vrubel/indicator-fun-V3s/README.md

# indicator-fun-V3s
Device "indicator.fun" implementation on the processor Allwinner V3s

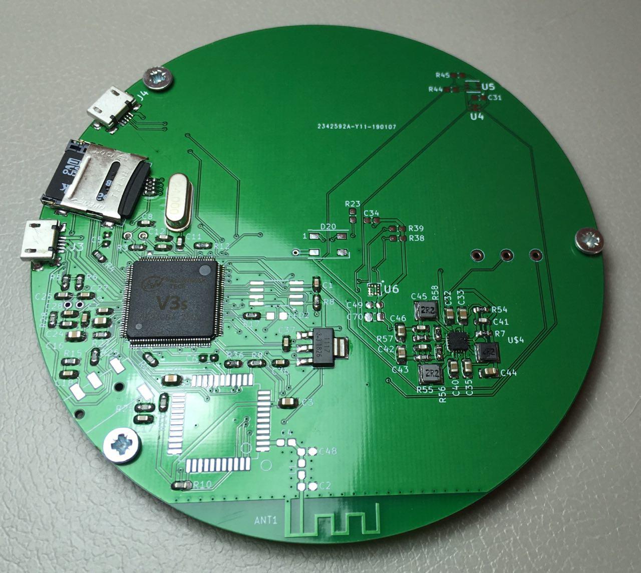
[picture p1: images/V1.0-bottom.jpg]
V1.0-bottom
  
   
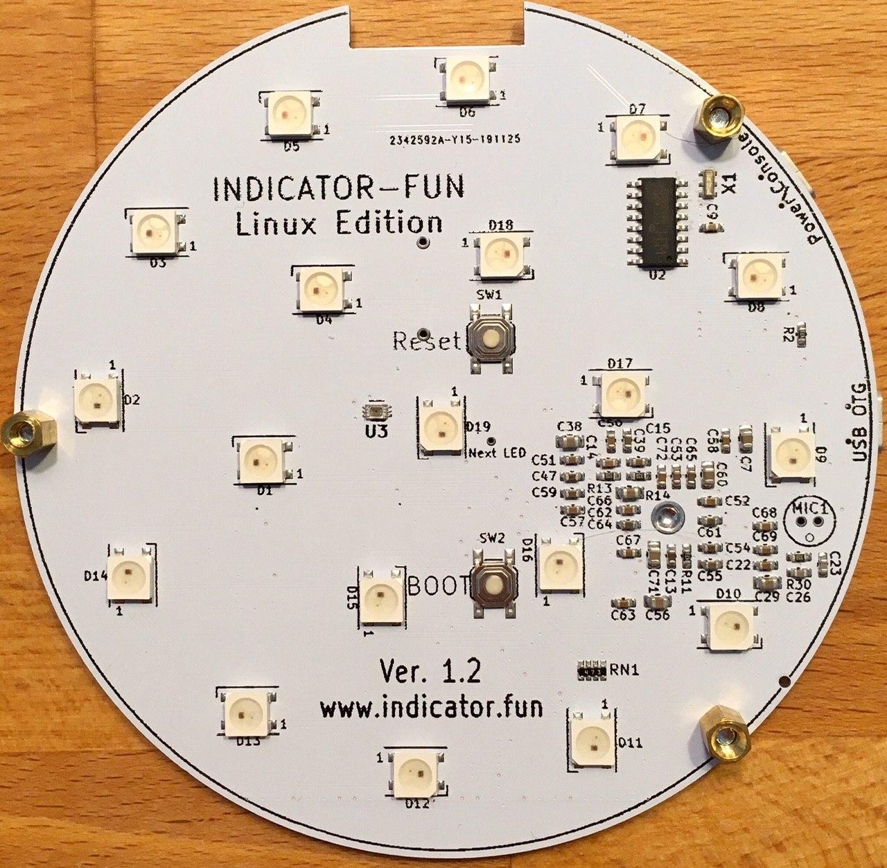
[picture p2: images/bottom-v-1.2.jpg]
V1.1-white-bottom
  
   
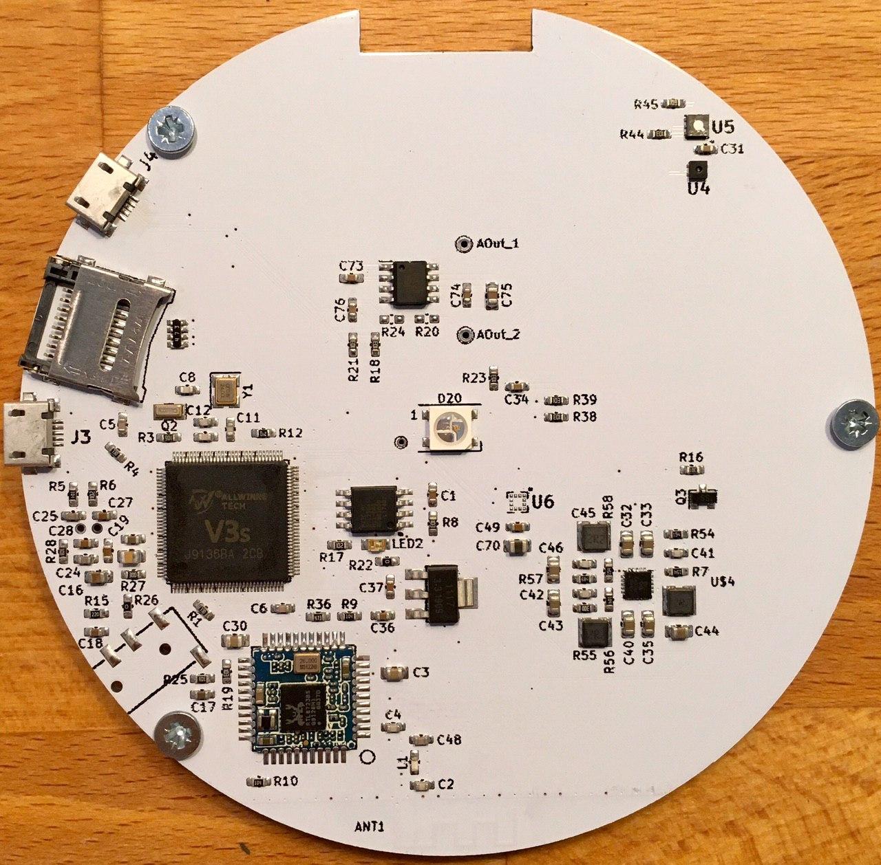
[picture p3: images/top-v-1.2.jpg]
V1.1-white-top
