vrubel/indicator-fun-V3s/Hardware/indicator-fun-v3s.kicad_pcb

## KiCad design Hardware/indicator-fun-v3s.kicad_pcb (2019-11-24)

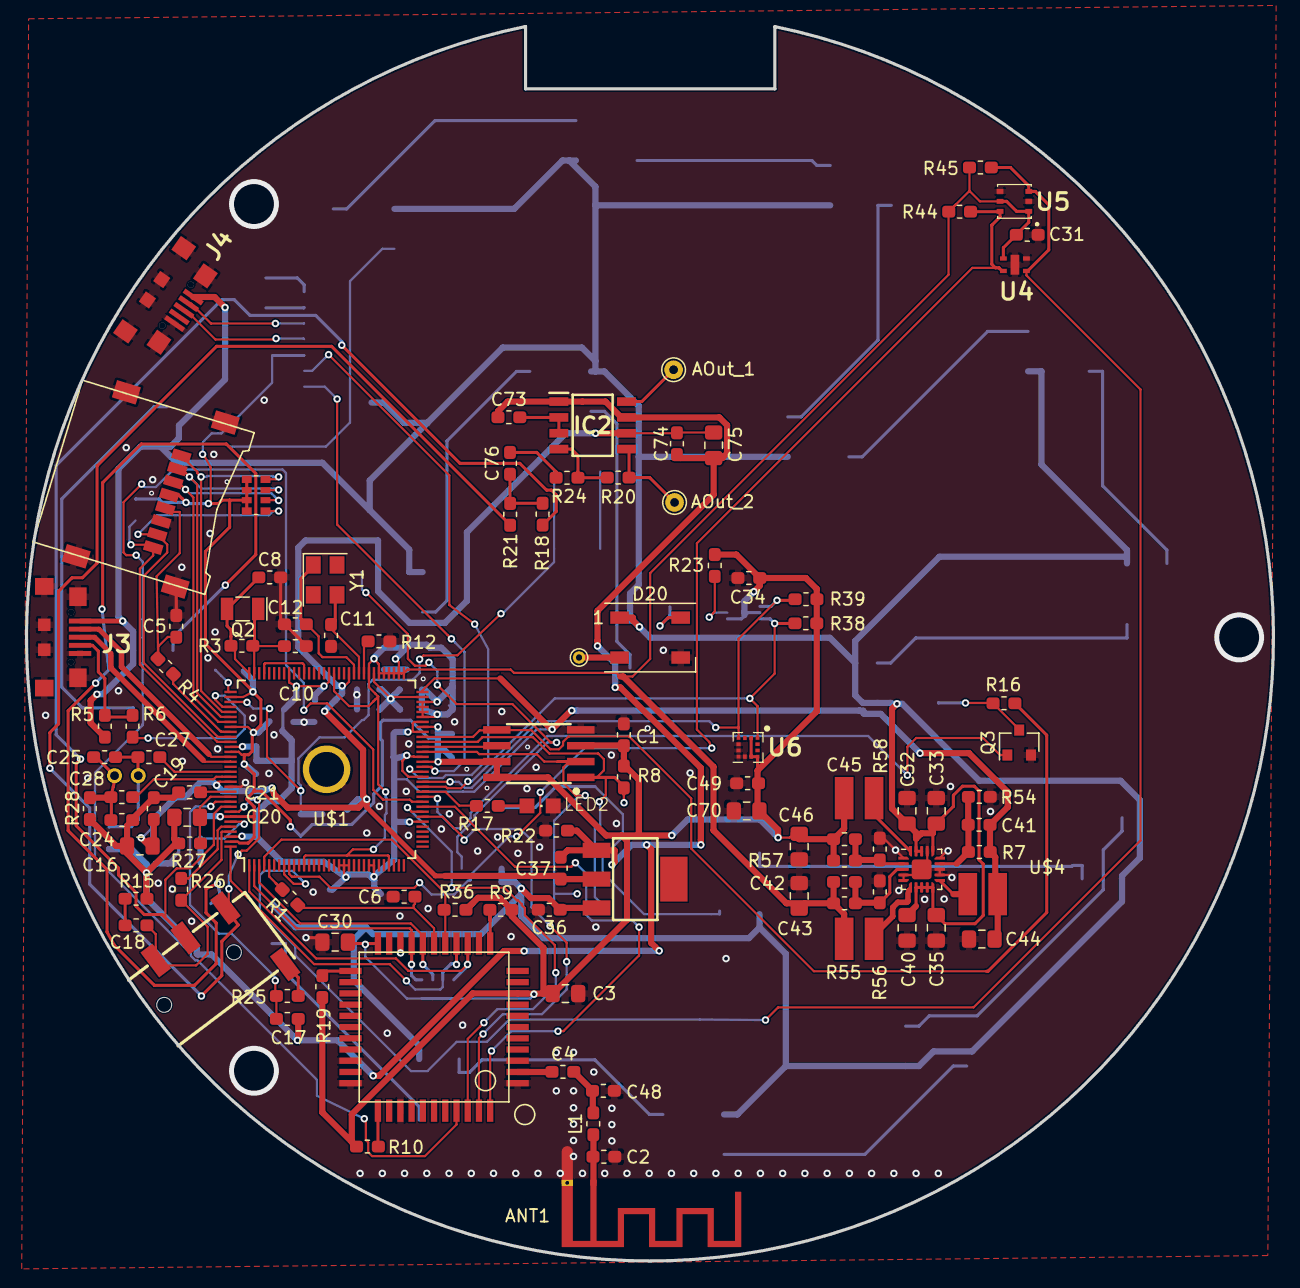
[picture p4: board indicator-fun-v3s.kicad_pcb from above]

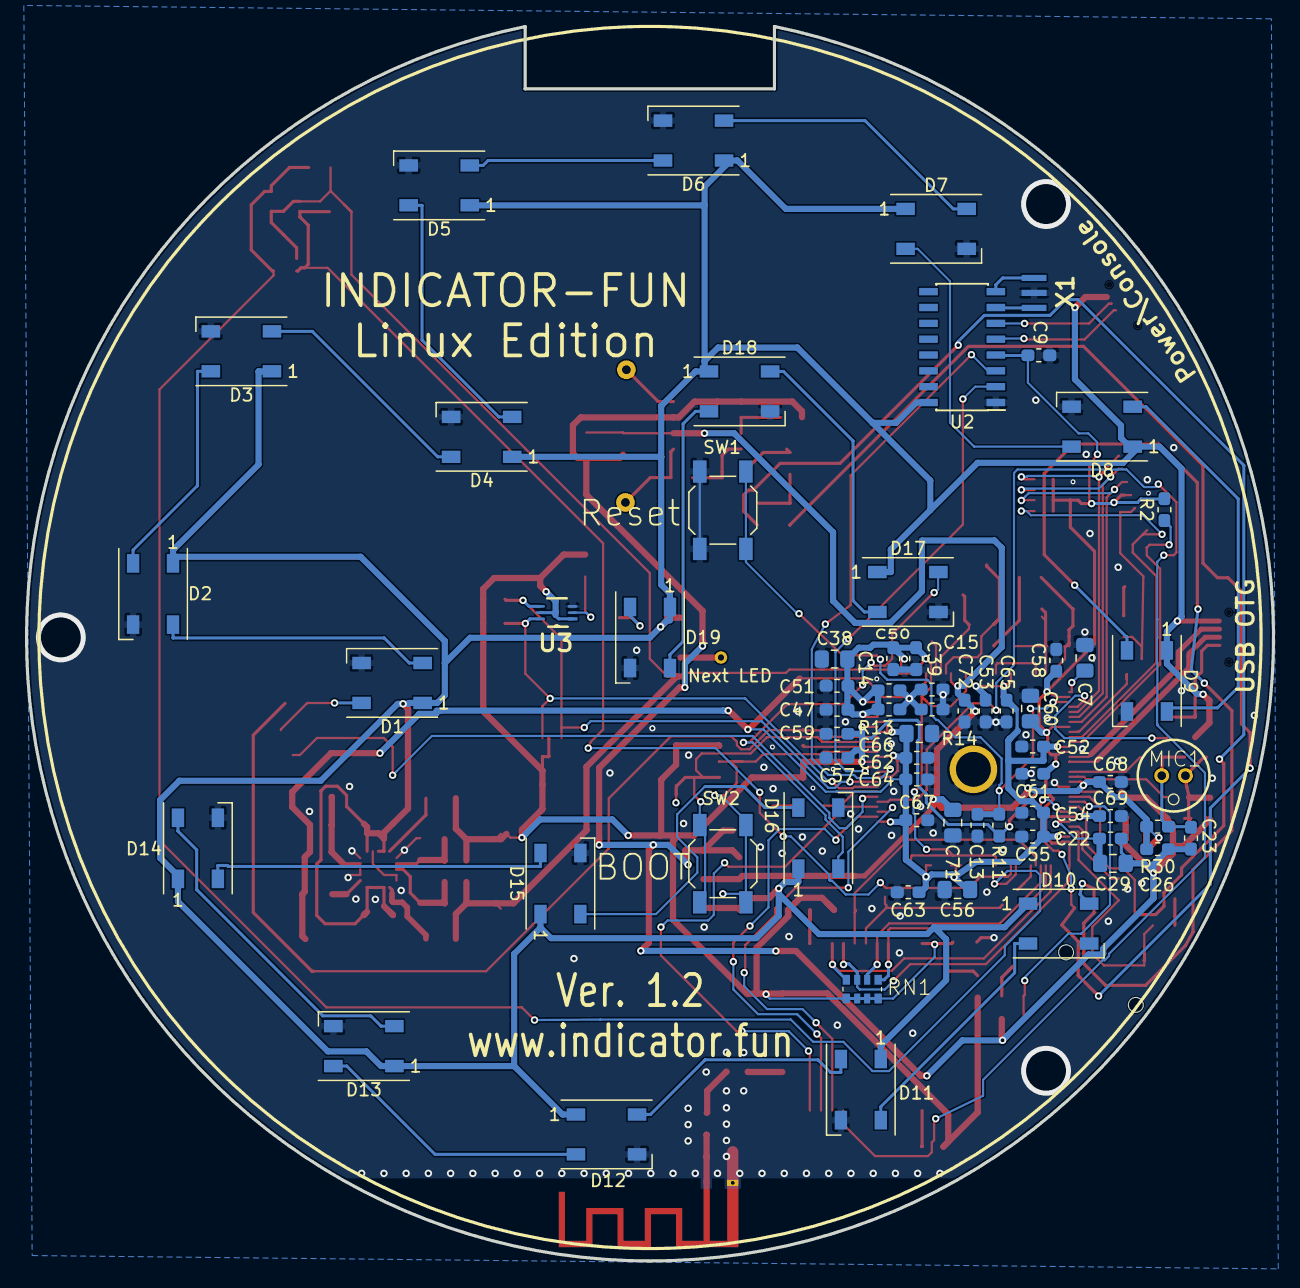
[picture p5: board indicator-fun-v3s.kicad_pcb from below]

Board: 2 copper layers, 100.0 x 99.0 mm, 168 parts (65 on the bottom side), 109 nets.

Parts:
ANT1: SWRA117D; Texas_SWRA117D_2.4GHz_Left
AOut_1: AOut_1; TestPoint_THTPad_D1.5mm_Drill0.7mm
AOut_2: AOut_2; TestPoint_THTPad_D1.5mm_Drill0.7mm
C1, C9, C14, C15, C18, C19, C22, C27, C28, C50, C51, C52, C53, C57, C58, C62, C63, C67, C68, C69, C72, C73, C74: 100nF; C_0603_1608Metric_Pad1.05x0.95mm_HandSolder
C2: 1pF; C_0603_1608Metric_Pad1.05x0.95mm_HandSolder
C3, C7, C16, C29, C30, C32, C33, C35, C38, C40, C43, C44, C46, C56, C60, C66, C71, C75: 10µF; C_0805_2012Metric_Pad1.15x1.40mm_HandSolder
C4: 10pF; C_0603_1608Metric_Pad1.05x0.95mm_HandSolder
C5, C6: 4.7pF; C_0603_1608Metric_Pad1.05x0.95mm_HandSolder
C8, C10, C11, C12, C41, C42, C45: 18pF; C_0603_1608Metric_Pad1.05x0.95mm_HandSolder
C13, C17, C21, C39, C47, C54, C55, C59, C61, C64, C65: 1µF; C_0603_1608Metric_Pad1.05x0.95mm_HandSolder
C20: 4.7µF; C_0805_2012Metric_Pad1.15x1.40mm_HandSolder
C23, C24, C26: 33pF; C_0603_1608Metric_Pad1.05x0.95mm_HandSolder
C25: 100pF; C_0603_1608Metric_Pad1.05x0.95mm_HandSolder
C31, C34, C49: 0.1uf; C_0603_1608Metric_Pad1.05x0.95mm_HandSolder
C36, C37: 100nf; C_0603_1608Metric_Pad1.05x0.95mm_HandSolder
C48: 1.2pF; C_0603_1608Metric_Pad1.05x0.95mm_HandSolder
C70: 22µF; C_0805_2012Metric_Pad1.15x1.40mm_HandSolder
C76: 0.22µF; C_0603_1608Metric_Pad1.05x0.95mm_HandSolder
D1, D2, D3, D4, D5, D6, D7, D8, D9, D10, D11, D12, D13, D14, D15, D16, D17, D18, D19, D20: WS2812B; LED_WS2812B_PLCC4_5.0x5.0mm_P3.2mm
IC1: LM1117; SOT223
IC2: MD8002A; SOIC127P600X175-8N
J1: TRANSFLASH-LOCK; TRANSFLASH-LOCK-SOCK
J2: AUDIO_JACK_SMD; AUDIO_JACK_3.5MM_TRRS_SMD_RA
J3: USB OTG; USB-B-Micro
J4: Power\Console; USB-B-Micro
L1: 2.2nH; L_0603_1608Metric_Pad1.05x0.95mm_HandSolder
L3, L4: 2,2µH; ODD-INDUCTOR
L5: 2.2µH; ODD-INDUCTOR
LED2: LEDCHIPLED_0805; CHIPLED_0805
MIC1: ELECTRET_MICROPHON-F6035AP; F6035AP
Q2: 32kHz; Crystal_SMD_MicroCrystal_CC7V-T1A-2Pin_3.2x1.5mm
Q3: BSS138; SOT-23
R1, R4: 33; R_0603_1608Metric_Pad1.05x0.95mm_HandSolder
R2, R11, R36: 47k; R_0603_1608Metric_Pad1.05x0.95mm_HandSolder
R3: 10M; R_0603_1608Metric_Pad1.05x0.95mm_HandSolder
R5, R9, R10, R56: 100k; R_0603_1608Metric_Pad1.05x0.95mm_HandSolder
R6, R17: 1k; R_0603_1608Metric_Pad1.05x0.95mm_HandSolder
R7, R54, R58: 150k; R_0603_1608Metric_Pad1.05x0.95mm_HandSolder
R8, R18, R19, R21, R38, R39, R44, R45: 10k; R_0603_1608Metric_Pad1.05x0.95mm_HandSolder
R12: 240 - 1%; R_0603_1608Metric_Pad1.05x0.95mm_HandSolder
R13, R14: 2k - 1%; R_0603_1608Metric_Pad1.05x0.95mm_HandSolder
R15: 22; R_0603_1608Metric_Pad1.05x0.95mm_HandSolder
R16: 300; R_0603_1608Metric_Pad1.05x0.95mm_HandSolder
R20: 68k; R_0603_1608Metric_Pad1.05x0.95mm_HandSolder
R22, R26: 0; R_0603_1608Metric_Pad1.05x0.95mm_HandSolder
R23: 10K; R_0603_1608Metric_Pad1.05x0.95mm_HandSolder
R24: 22k; R_0603_1608Metric_Pad1.05x0.95mm_HandSolder
R25, R28, R30: 2k; R_0603_1608Metric_Pad1.05x0.95mm_HandSolder
R27: 200k 1%; R_0603_1608Metric_Pad1.05x0.95mm_HandSolder
R55: 200k; R_0603_1608Metric_Pad1.05x0.95mm_HandSolder
R57: 680k; R_0603_1608Metric_Pad1.05x0.95mm_HandSolder
RN1, RN2: 4R-NEXB38V; EXB38V
SW1: Reset; SW_SPST_SKQG_WithoutStem
SW2: BOOT; SW_SPST_SKQG_WithoutStem
TP1: Next LED; TestPoint_THTPad_D1.0mm_Drill0.5mm
U1: 25F32006WSOI; SO08-EIAJ
U2: CH340G; SOIC-16_3.9x9.9mm_P1.27mm
U3: Rohm BH1730FVC-TR; SOP6_1
U4: Sensirion SHTC1; Sensirion-SHTC1
U5: SGP30
U6: LIS2DH12TR; LGA-12_1
U$1: V3S; LQFP-128_14x14mm_P0.4mm
U$2: RTL8723BS; LGA
U$4: EA3036; QFN-20-1EP_3x3mm_P0.45mm_EP1.6x1.6mm
X1: CSTCE12M0G52-R0
Y1: Crystal_GND24_Small; Crystal_SMD_SeikoEpson_FA238V-4Pin_3.2x2.5mm

Connections:
+1V2: C41.1, C44.2, C52.1, C53.1, C54.1, C55.1, C56.1, C62.1, C63.1, C64.1, C65.1, C66.1, C67.1, L3.P$1, R7.1, U$1.19, U$1.20, U$1.21, U$1.25, U$1.26, U$1.38, U$1.47, U$1.51, U$1.56, U$1.58, U$1.64, U$1.80, U$1.88, U$1.108, U$1.126
+1V8: C14.2, C31.1, C38.2, C39.1, C42.1, C43.2, C47.1, C50.1, C51.1, L4.P$1, R13.2, R44.1, R45.1, R55.1, U4.1, U5.1, U5.5, U$1.12, U$1.29, U$1.59, U$1.60, U$1.61, U$1.62, U$1.65, U$1.66, U$1.67, U$1.68, U$1.69, U$1.70, U$1.72, U$1.79
+3V3: C1.1, C3.1, C9.1, C30.1, C34.1, C45.1, C46.2, C49.2, C57.1, C58.1, C59.1, C60.1, C61.1, C69.1, C70.2, J1.4, L5.P$1, R2.2, R8.2, R9.1, R10.2, R11.2, R19.2, R23.1, R36.1, R38.1, R39.1, R57.1, RN1.1, RN1.2, RN1.3, RN1.4, RN2.1, RN2.2, RN2.3, RN2.4, U1.3, U1.7, U1.8, U2.4, U3.1, U3.5, U6.2, U6.9, U6.10, U$1.50, U$1.57, U$1.98, U$1.104, U$1.109, U$1.122, U$1.127, U$2.P$9, U$2.P$22
+3V3A: C16.2, C19.2, C26.2, C37.1, C68.1, C71.1, C72.1, C74.1, C75.2, IC1.2, IC2.6, R30.2, U$1.76, U$1.115
+5V: C32.1, C33.1, C35.1, C36.1, C40.1, D1.1, D2.1, D3.1, D4.1, D5.1, D6.1, D7.1, D8.1, D9.1, D10.1, D11.1, D12.1, D13.1, D14.1, D15.1, D16.1, D17.1, D18.1, D19.1, D20.1, IC1.3, J3.1, J4.1, R5.2, U2.16, U$4.7, U$4.8, U$4.9, U$4.10, U$4.16, U$4.18, U$4.19
/Power/SVREF: C14.1, C15.2, R13.1, R14.2, U$1.63, U$1.71
/Power/for_delete: U$1.85, U$1.93
/Power/x24min: C12.2, U$1.75, Y1.1
/Power/x24mount: C11.2, U$1.74, Y1.3
/Power/x32kin: C8.1, Q2.2, R3.2, U$1.96
/Power/x32kout: C10.1, Q2.1, R3.1, U$1.95
/Sensors/Light-Int: R23.2, U3.2
/USB-SDC0-Audio/HP_COM: C18.2, J2.RING2, R26.2, U$1.125
/USB-SDC0-Audio/HP_COMFB: R26.1, U$1.124
/USB-SDC0-Audio/HP_L: J2.TIP, R21.1, U$1.121
/USB-SDC0-Audio/HP_R: J2.RING1, R18.1, U$1.120
/USB-SDC0-Audio/MICIN1N: C28.1, U$1.114
/USB-SDC0-Audio/MICIN1P: C27.1, U$1.113
/USB-SDC0-Audio/MIC_HBIAS: C17.1, R25.2, U$1.119
/USB-SDC0-Audio/USB_D+: J3.3, U$1.111
/USB-SDC0-Audio/USB_D-: J3.2, U$1.110
/USB-SDC0-Audio/VRA1: C21.2, U$1.117
/USB-SDC0-Audio/VRA2: C20.2, R27.2, U$1.118
/WLAN/SDC1/CLK: C6.1, R1.1, U$2.P$17
/WLAN/SDC1/CMD: R36.2, U$1.4, U$2.P$16
/WLAN/SDC1/D0: RN1.6, U$1.3, U$2.P$18
/WLAN/SDC1/D1: RN1.5, U$1.2, U$2.P$19
/WLAN/SDC1/D2: RN1.8, U$1.1, U$2.P$14
/WLAN/SDC1/D3: RN1.7, U$1.128, U$2.P$15
/WLAN/SPI1/CS: R8.1, SW2.3, SW2.4, U1.1, U$1.54
/WLAN/SPI1/MISO: SW2.1, SW2.2, U1.2, U$1.52
/WLAN/SPI1/SCK: U1.6, U$1.53
/WLAN/UART2/CTS/PB3: U$1.42, U$2.P$41
/WLAN/UART2/RTS/PB2: U$1.41, U$2.P$44
/WLAN/UART2/RX/PB1: U$1.40, U$2.P$42
/WLAN/UART2/TX/PB0: U$1.39, U$2.P$43
AGND: C16.1, C17.2, C19.1, C20.1, C21.1, C22.2, C23.1, C24.1, C26.1, C29.1, C37.2, C73.1, C74.2, C75.1, IC1.1, IC2.1, IC2.7, R15.1, R22.1, R27.1, R28.2
CS2: Q3.1, U$1.43
GND: ANT1.2, C1.2, C2.1, C3.2, C5.2, C6.2, C7.2, C8.2, C9.2, C10.2, C11.1, C12.1, C13.2, C15.1, C30.2, C31.2, C32.2, C33.2, C34.2, C35.2, C36.2, C38.1, C39.2, C40.2, C43.1, C44.1, C46.1, C47.2, C48.1, C49.1, C50.2, C51.2, C52.2, C53.2, C54.2, C55.2, C56.2, C57.2, C58.2, C59.2, C60.2, C61.2, C62.2, C63.2, C64.2, C65.2, C66.2, C67.2, C68.2, C69.2, C70.1, C71.2, C72.2, D1.3, D2.3, D3.3, D4.3, D5.3, D6.3, D7.3, D8.3, D9.3, D10.3, D11.3, D12.3, D13.3, D14.3, D15.3, D16.3, D17.3, D18.3, D19.3, D20.3, J1.6, J1.S1, J1.S2, J1.S3, J1.S4, J3.5, J4.5, LED2.C, Q3.2, R12.2, R14.1, R22.2, R54.1, R56.1, R58.1, SW1.1, SW1.2, U1.4, U2.1, U3.3, U4.4, U4.5, U5.2, U5.4, U6.5, U6.6, U6.7, U6.8, U$1.116, U$1.P$1, U$2.P$1, U$2.P$3, U$2.P$20, U$2.P$31, U$2.P$33, U$2.P$36, U$4.1, U$4.4, U$4.5, U$4.12, U$4.13, U$4.15, U$4.17, U$4.21, X1.2
LED_CTL: R16.1, U1.5, U$1.55
unnamed: ANT1.1, C2.2, L1.1
unnamed: AOut_1.1, IC2.8
unnamed: AOut_2.1, IC2.5, R20.2
unnamed: C4.1, U$2.P$2
unnamed: C4.2, C48.2, L1.2
unnamed: C7.1, U$1.97
unnamed: C13.1, R11.1, SW1.3, SW1.4, U$1.99
unnamed: C18.1, R15.2
unnamed: C22.1, C29.2, U$1.123
unnamed: C23.2, C25.2, C27.2, MIC1.2, R30.1
unnamed: C24.2, C25.1, C28.2, MIC1.1, R28.1
unnamed: C41.2, R7.2, R54.2, U$4.14
unnamed: C42.2, R55.2, R56.2, U$4.3
unnamed: C45.2, R57.2, R58.2, U$4.2
unnamed: C73.2, IC2.2, IC2.3
unnamed: C76.1, R18.2, R21.2
unnamed: C76.2, R24.1
unnamed: D1.2, D2.4
unnamed: D1.4, Q3.3, R16.2
unnamed: D2.2, D3.4
unnamed: D3.2, D4.4
unnamed: D4.2, D5.4
unnamed: D5.2, D6.4
unnamed: D6.2, D7.4
unnamed: D7.2, D8.4
unnamed: D8.2, D9.4
unnamed: D10.2, D11.4
unnamed: D9.2, D10.4
unnamed: D11.2, D12.4
unnamed: D12.2, D13.4
unnamed: D13.2, D14.4
unnamed: D14.2, D15.4
unnamed: D15.2, D16.4
unnamed: D16.2, D17.4
unnamed: D17.2, D18.4
unnamed: D18.2, D19.4
unnamed: D19.2, D20.4
unnamed: D20.2, TP1.1
unnamed: IC2.4, R20.1, R24.2
unnamed: J2.EARTH, R25.1
unnamed: J3.4, R5.1, R6.1
unnamed: J4.2, U2.6
unnamed: J4.3, U2.5
unnamed: L3.P$2, U$4.11
unnamed: L4.P$2, U$4.6
unnamed: L5.P$2, U$4.20
unnamed: LED2.A, R17.1
unnamed: R1.2, U$1.5
unnamed: R4.2, U$1.105
unnamed: R9.2, U$2.P$12
unnamed: R10.1, U$2.P$34
unnamed: R12.1, U$1.73
unnamed: R19.1, U$2.P$23
unnamed: U2.7, X1.1
unnamed: U2.8, X1.3
PWM1_SYSLED: R17.2, U$1.44
SCL: R38.2, U3.6, U6.1, U$1.45
SCL-1.8: R44.2, U4.2, U5.6, U$1.9
SDA: R39.2, U3.4, U6.4, U$1.46
SDA-1.8: R45.2, U4.3, U5.3, U$1.8
SDC0/CLK: C5.1, J1.5, R4.1
SDC0/CMD: J1.3, RN2.6, U$1.103
SDC0/D0: J1.7, RN2.5, U$1.106
SDC0/D1: J1.8, R2.1, U$1.107
SDC0/D2: J1.1, RN2.8, U$1.101
SDC0/D3: J1.2, RN2.7, U$1.102
UART0/RX: U2.2, U$1.49
UART0/TX: U2.3, U$1.48
USB/ID: R6.2, U$1.100
