vrubel/indicator-fun-V3s/changelog.md

Change Log
All notable changes to this project will be documented in this file.

The format is based on [Keep a Changelog](http://keepachangelog.com/)
and this project adheres to [Semantic Versioning](http://semver.org/).

## [1.1] - 06.06.2019
### Изменено 
- С предыдущей версией платы, удалось управлять цепочкой светодиодов при помощи SPI. Удалось посадить на один контроллер SPI как светодиоды, так и NOR флеш память (используя дополнительный CS). Как следствие на плату был добавлен один полевик для разрешения прохождения сигнала на светодиоды.

### Удалено
- Гребенка с выведенными для эксперимента сигналами SPI и PWM (нога PWM в этой ревизии используется как CS2 для разрешения сигнала на светодиоды)

### Примечания
- С предыдущей версией платы была проверена работа WiFi. Все OK. Оставляем используемый модуль WiFi.

## [1.0] - 07.01.2019
### Added
- Отправлена в производство первая версия платы
- Для управления цепочкой светодиодов выведены на гребенку сигналы PWM и SPI с процессора (для экспериментов, каким удасться управлять цепочкой)
