vrubel/indicator-fun-V3s/(commit log)

2019-05-16 ver 1.0 Operable device
    [Leds.sch, Power.sch, Sensors.sch, USB-SDC0-Audio.sch, WLAN.sch, indicator-fun-v3s.kicad_pcb, indicator-fun-v3s.sch]
2019-05-16 Added a photo of the assembled PCB
2019-06-02 SPI подсоединен к цепочке светодиодов и установлен транзистор разрешающий управление цепочкой по CS2
    [Leds.sch, WLAN.sch, indicator-fun-v3s.kicad_pcb]
2019-06-02 Заменены кварцы
    [Power.sch, indicator-fun-v3s.kicad_pcb]
2019-06-06 Версия 1.1 Отправлена в производство
    [indicator-fun-v3s.kicad_pcb]
2019-10-26 Переход на новую версию KiCad
    [Leds.sch, Power.sch, Sensors.sch, USB-SDC0-Audio.sch, WLAN.sch, indicator-fun-v3s.kicad_pcb, indicator-fun-v3s.sch]
2019-10-26 Новые картинки
2019-11-24 Добавлен усилитель, но не сделана трассировка дорожек
    [Leds.sch, Power.sch, Sensors.sch, USB-SDC0-Audio.sch, WLAN.sch, indicator-fun-v3s.kicad_pcb, indicator-fun-v3s.sch]
2019-11-24 Разведены две дорожки звука на усилитель
    [indicator-fun-v3s.kicad_pcb]
2019-11-24 Разведена шина AGND
    [Power.sch, USB-SDC0-Audio.sch, indicator-fun-v3s.kicad_pcb, indicator-fun-v3s.sch]
2019-11-24 Добавлен вырез под динамик
    [USB-SDC0-Audio.sch, indicator-fun-v3s.kicad_pcb]
2020-03-29 Добавлена html страница InteractiveHtmlBom для версии 1.2
